jerusalem-science-museum/train_outside/אביזרים/truck_crane_nadneda/pic/20260311_140529.jpg

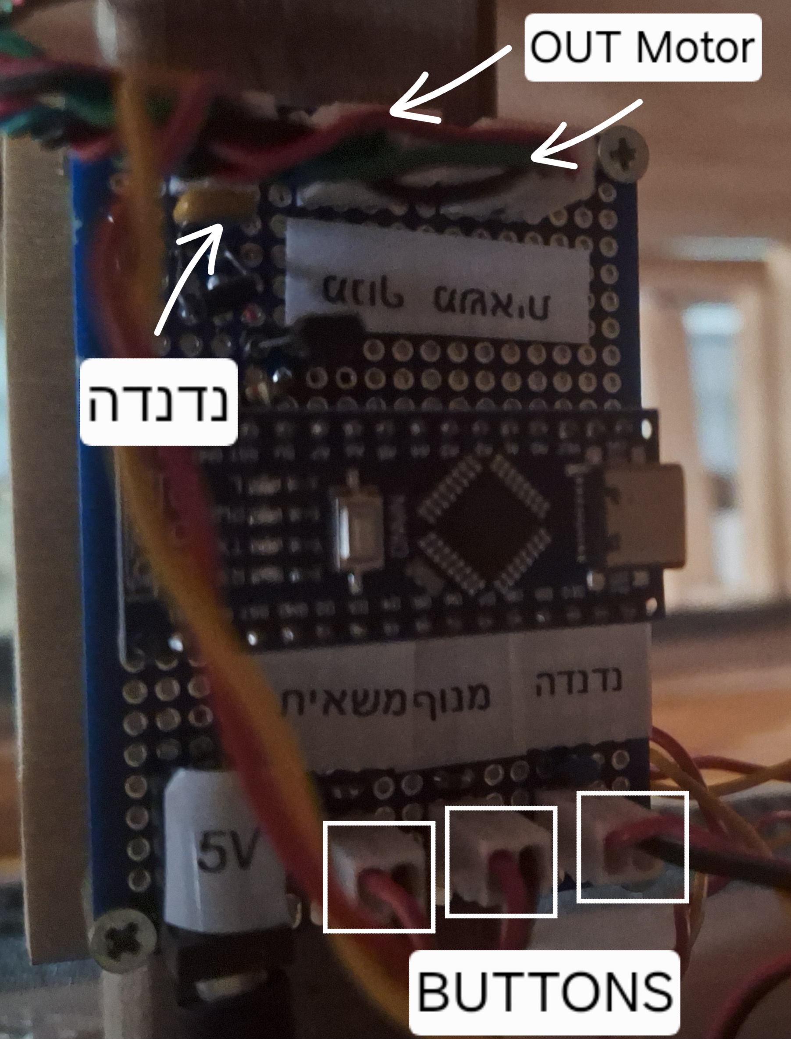
אביזרים/truck_crane_nadneda/pic/20260311_140529.jpg
