jerusalem-science-museum/train_outside/אביזרים/home_smoke/pic/20260309_175854.jpg

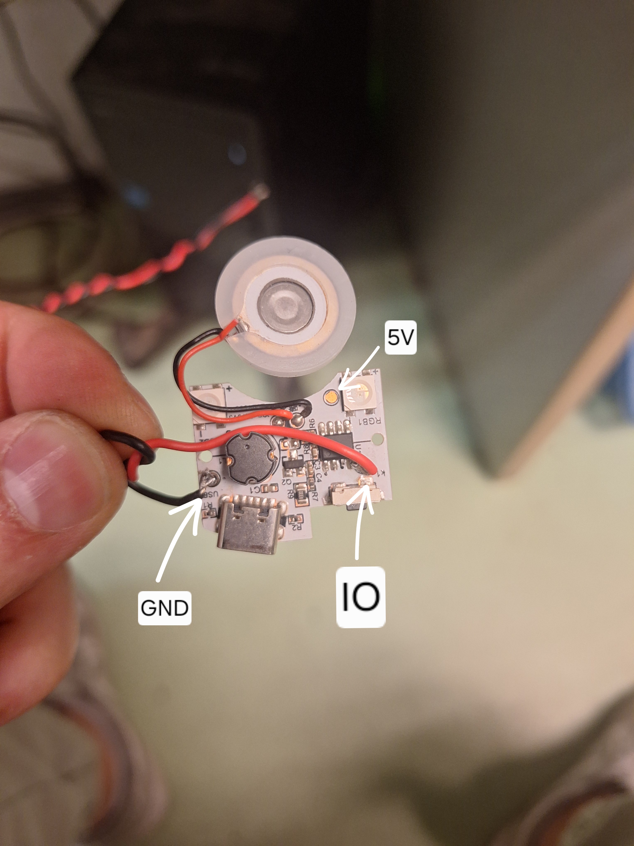
אביזרים/home_smoke/pic/20260309_175854.jpg
