jerusalem-science-museum/train_outside/פס רכבת/Easyeda_pcb/version2/Gerber_PCB_Train_Barrierx7_Opto/How-to-order-PCB.txt

How to Order PCB

Please refer to:
https://docs.easyeda.com/en/PCB/Order-PCB
