jerusalem-science-museum/train_outside/פס רכבת/אמיר/Train track controller.docx

## Story

Train track with n segments, and m trains (m < n). Track is a closed loop.

Controllers ensures that there are no more than one train in any segment

## Terminology

- Segment: a part of track
- Barrier: on entrance to a segment there is a barrier, if barrier is closed, trains cannot go into segment
- Sensor: after every barrier there is a sensor for detecting trains

Segment 1

Segment 2

Segment 3

barrier 1

barrier 2

barrier 3

sensor 1

sensor 2

sensor 3

## Algorithm

### Initial state:

- All barriers are closed

### Control:

- For every sensor i:

If sensor detects a train:

Close the barrier with index i (detected a train in segment i, therefore dont allow entrance)

Open the barrier with index i - 1 (the train came from i-1, so its free)

### Start flow

When we want to start the flow (when we turn on the system all barriers are closed), we need to “activate” manually the sensor that is “before” one of the trains

- Do we have access?
- Do we want to have a different method?

## Sensors

1. E3JK-R2M2:
  a. Relay output
  b. Retroreflector
  c. 12V+

##### 2. E18-D80NK

  a. 5V

# 3. E3F-DS30

  a. 6V
  b. npn/pnp/no/nc

## Output signal to barrier

Assumption: output is a “dry contact” (barrier has 2 wires, common and signal, and we short/ open the connection between them using a relay)
