jerusalem-science-museum/train_outside/נוהל סגירת קרון נכון לדצמבר 25.docx

נוהל סגירת קרון

סגירת קרון היא חלק אינטגרלי וחשוב בהפעלת המודל. סגירה נכונה ו"נקיה" תקל מאוד על התחלת ההפעלה הבאה.

מכיוון שהתהליך לוקח מספר דקות ורכבות רצות תוך ההליך ניתן לעשות זאת בנוכחות קהל אחרי הודעה לקהל שמתחילים לסגור.

מטרת הנוהל היא לא רק להשבית תנועת רכבות על המודל אלא להכין את המודל להפעלה הבאה. בסוף הנוהל כל הרכבות אמורות להיות בנקודת ההתחלה שלהם כשהן יושבות היטב על הפסים יחד עם קרונותיהם בהנחה שהללו מחוברים.

לעניין הקרונות: בשלב זה מדריכים מתבקשים שלא לחבר קרונות לרכבות עד שנלמד יותר טוב את הטכניקה ואז תועבר (בתקווה) הטכניקה למדריכים. מובן שקרונות שהתנתקו מרכבות צרכים להיות מוסרים מהפסים לא רק בנוהל הסגירה אלא כל אימת שניתוק כזה התרחש על מנת למנוע התנגשויות וקצרים. כרגיל זה נכון כמובן גם לרכבות אמתיות רק ,ששוב כרגיל ,הנזקים יכולים להיות הרבה יותר גדולים ולסכן חיי אדם והיו דברים מעולם..

נקודות הסיום (וההתחלה):

במקרה ומפעילים 4 רכבות נקודות הסיום הם ליד רמזורים ;1,7,6,5

במקרה ומפעילים 5 רכבות נקודות הסיום הם ליד רמזורים 1,7,6,5,4

הרכבת שמול רמזור 1 אינה עומדת ליד הרמזור עצמו אלא מול הסנטרל (ה"מחשב")

נוהל הסגירה:

במידה וקטרים רצים ללא קרונות מכבים ומדליקים את הארדואינו (סגירת כל הרמזורים) מורידים מהירויות לאפס דרך הסנטרל (ה"מחשב") ,מרימים את הקטרים ומניחים במקומות הנכונים תוך כדי שמוודאים שהם יושבים על הפסים כמו שצריך.

במידה ומחוברים קרונות לקטרים: אין להוריד בשום פנים רכבות עם קרונות מהפסים. זה ינתק את הקרונות. נכון לכרגע ומסיבות טכניות שונות חיבור הקרונות לקטרים דורש זמן ותשומת לב מרובה ומדריכים אינם מורשים לעשות זאת לעת עתה. הבאת הרכבות למקומות הנכונים תעשה במקרה זה בנסיעה בלבד.

הדרך הפשוטה ביותר היא כשהקטר הראשון בסבב מגיע מול הסנטרל יש להוריד את מהירותו ל-0 שאר הקטרים אמורים להגיע בעצמם לרמזורים ולהיעצר שם. שימו לב שכל הרכבות נמצאות מאחורי הרכבת הראשונה בסבב ולא צפויות התנגשויות. אחרת המשיכו להריץ עד להשגת התנאים הנכונים.

במקרה והרכבות לא הגיעו למקומות הנכונים יש להסיע אותן אחת אחת ע"י שליטה בארדואינו ובמהירויות. הסתכלות על הפסים וחשיבה יסיעו לעשות זאת יחסית בקלות.

לאחר שהרכבות הגיעו לתחנות הנכונות יש להוריד המהירות לאפס לכולם כך שמי שמתחיל שוב יוכל לבחור מהירויות בהתאם לצרכים.

ברגע שכל הרכבות במקומותיהם ומהירותם אפס אפשר לסגור את מתג החשמל הראשי של הקרון (מתג אדום על הקיר ב"חדרון") לצאת ולנעול את הקרון (מפתח מסטר ולא לשכוח).
