jerusalem-science-museum/train_outside/פס רכבת/סיכום_משא.docx

מיקום תחנות ו-Feedback.

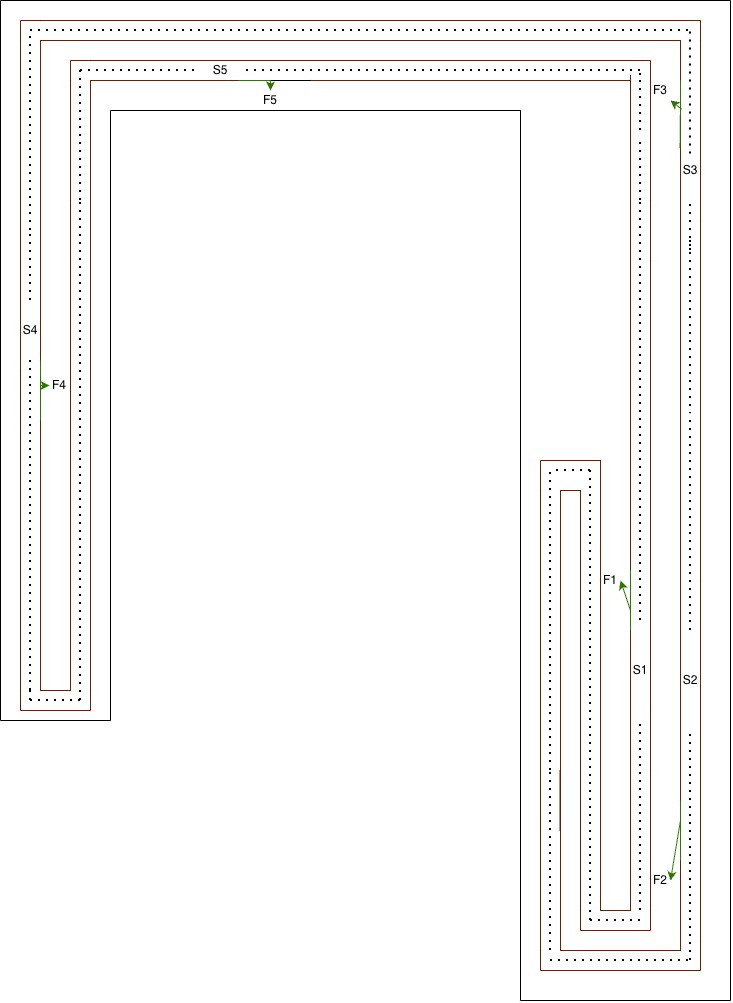
[picture p3: figure]

קופסת אלקטרוניקה

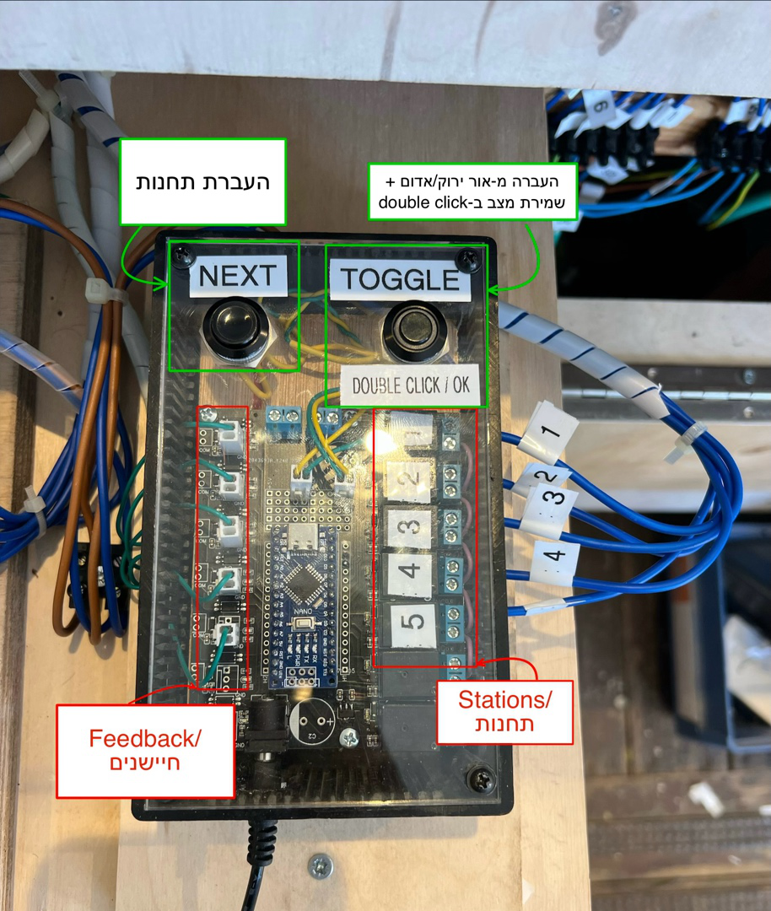
[picture p4: figure]
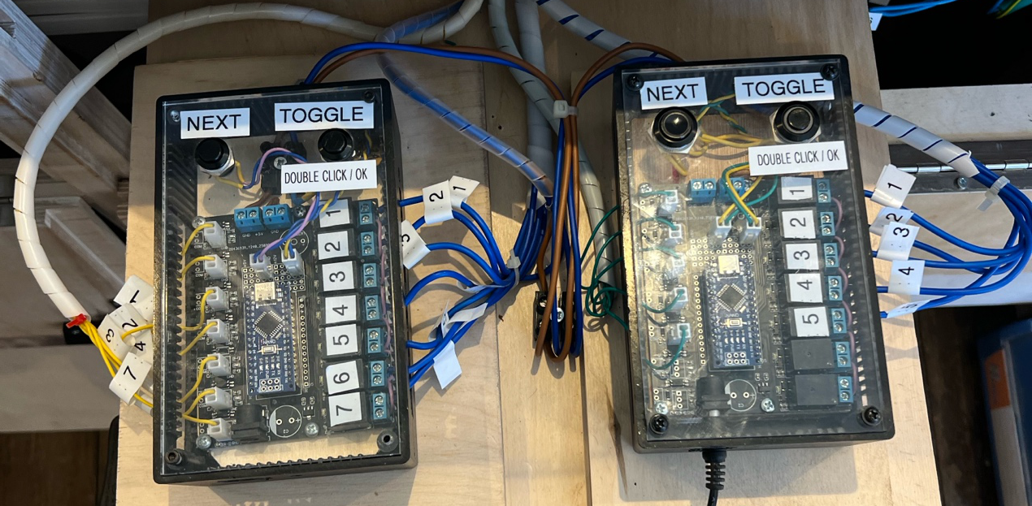
[picture p5: figure]

המערכות אחד ליד השני:

מערכת משא

מערכת נוסעים

חיווטים של התחנות:

משא

נוסעים

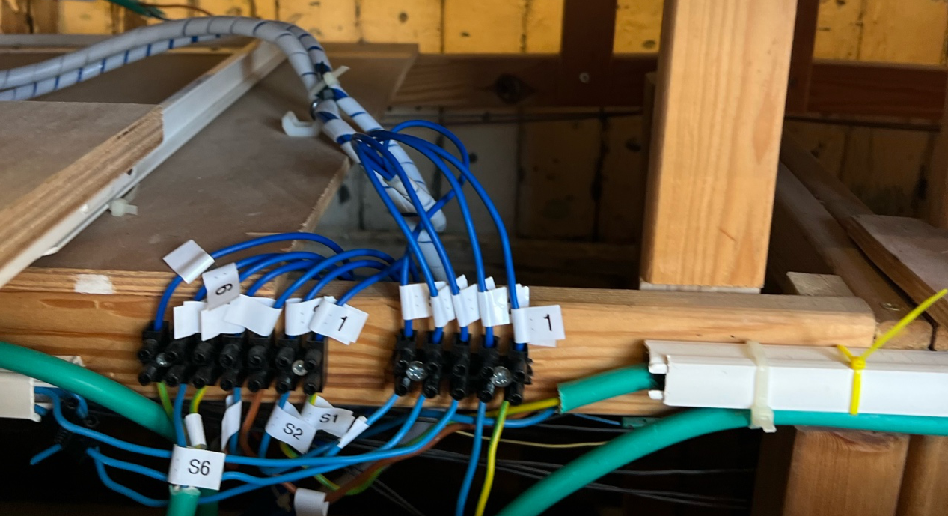
[picture p6: figure]

להפעלת המערכת ישנו מספר שלבים:

1. הדלקת ספק 12V.ברגע שמדליקים את הספק כל הלדים של התחנות נדלקות (כאשר לד של תחנה נדלק אין מתח בפסים הרמזור אדום).
2. בחירת תחנות. יש שתי כפתורים לבחירת תחנות ושנות את מצבם.
  - NEXT: מאפשר לעבור לתחנה הבאה (מ-1 ל-2...) וגם הופך את הרמזור לירוק
  - TOGGLE: מאפשר לעבור מאור ירוק לאור לאדום (שינוי מצב התחנה).
3. אישור סופי של בחירת תחנות. כאשר סיימנו לבחור את התחנות אם לוחצים Double Click על ה-TOGGLE אנו מאשרים את המסלול ולא ניתן לשנותו אלא על ידי ניתוק וחיבור הספק 12V.
4. למקם את הקרונות לתחנות הרלוונטיות.
5. לחיצה על כפתור STOP של ה-CENTRAL כדי לאפשר לתת מתח בפסים

מספר חיישן עם מספור מהמערכת הישנה

F1 → 12

F2 → 15

F3 → 18

F4 → 21

F5 → 22
