jerusalem-science-museum/train_outside/אביזרים/אזורים/אזור 1,2.jpg

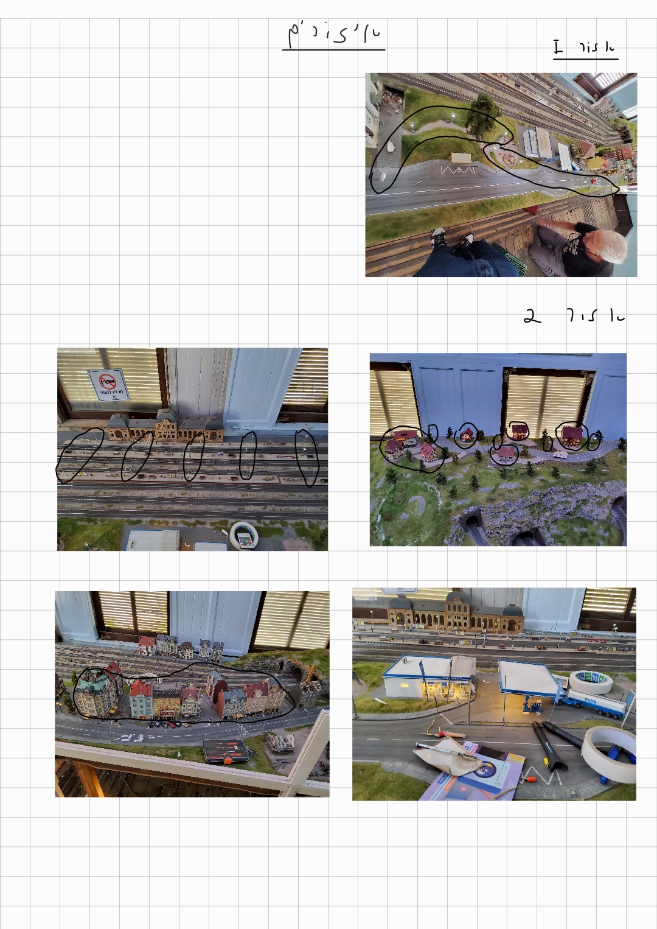
אביזרים/אזורים/אזור 1,2.jpg
