jerusalem-science-museum/train_outside/אביזרים/אזורים/אזור 3.jpg

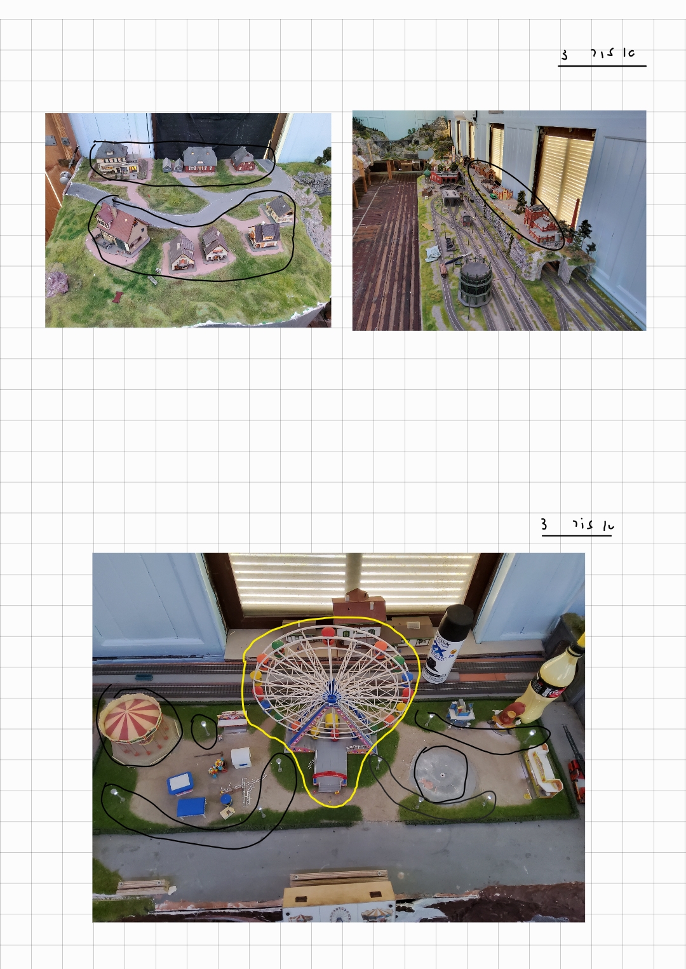
אביזרים/אזורים/אזור 3.jpg
