jerusalem-science-museum/train_outside/אביזרים/אזורים/אזור 4,5,6.jpg

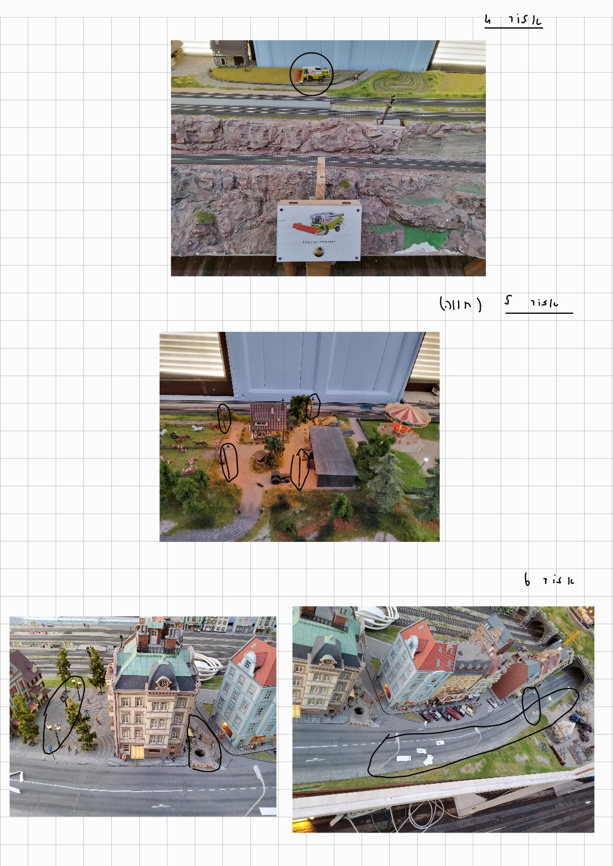
אביזרים/אזורים/אזור 4,5,6.jpg
