jerusalem-science-museum/train_outside/אביזרים/אזורים/אזור 7,8.jpg

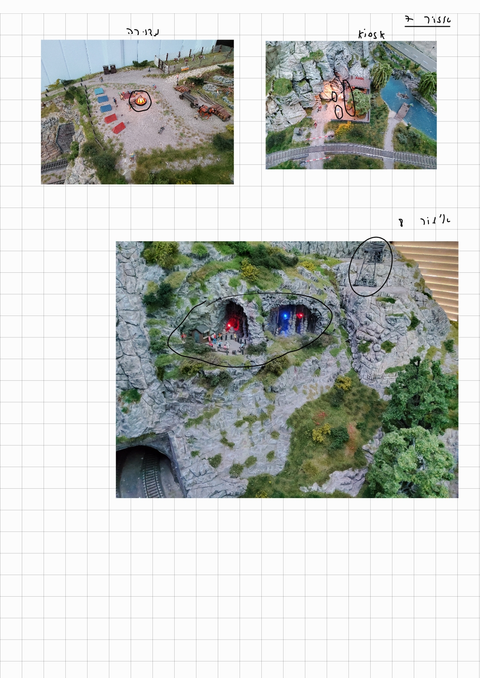
אביזרים/אזורים/אזור 7,8.jpg
