jerusalem-science-museum/train_outside/אביזרים/ספקים/ספק 1,2,3.jpg

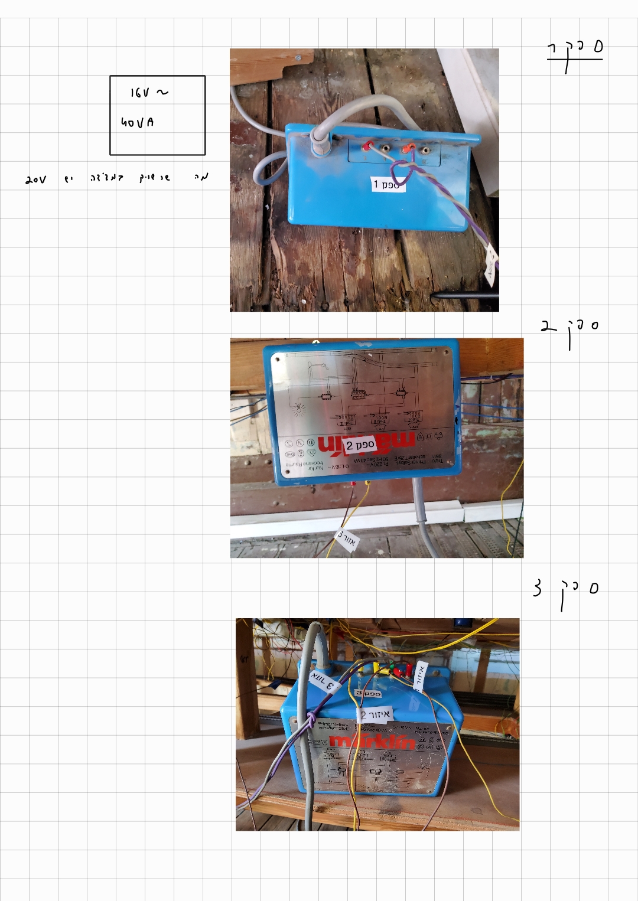
אביזרים/ספקים/ספק 1,2,3.jpg
