jerusalem-science-museum/train_outside/אביזרים/ספקים/ספק 4,5,6.jpg

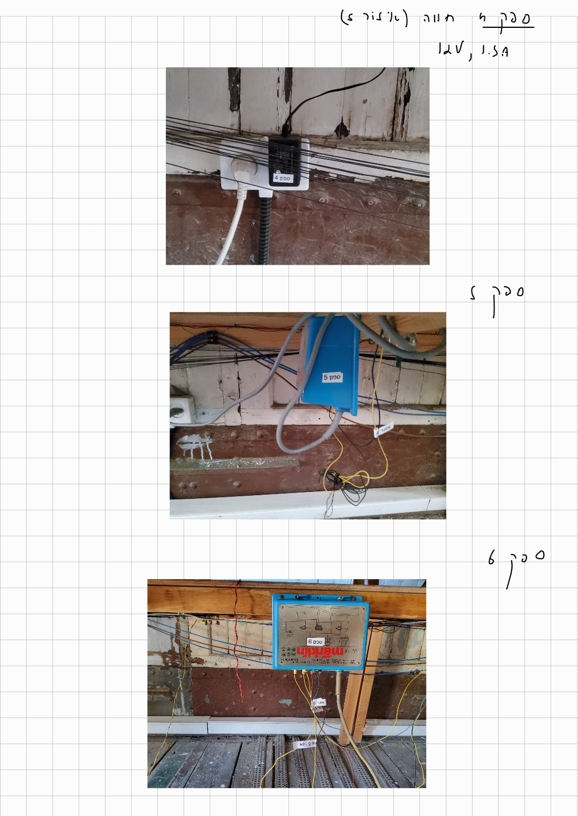
אביזרים/ספקים/ספק 4,5,6.jpg
