jerusalem-science-museum/train_outside/אביזרים/ספקים/ספק 7,8,9.jpg

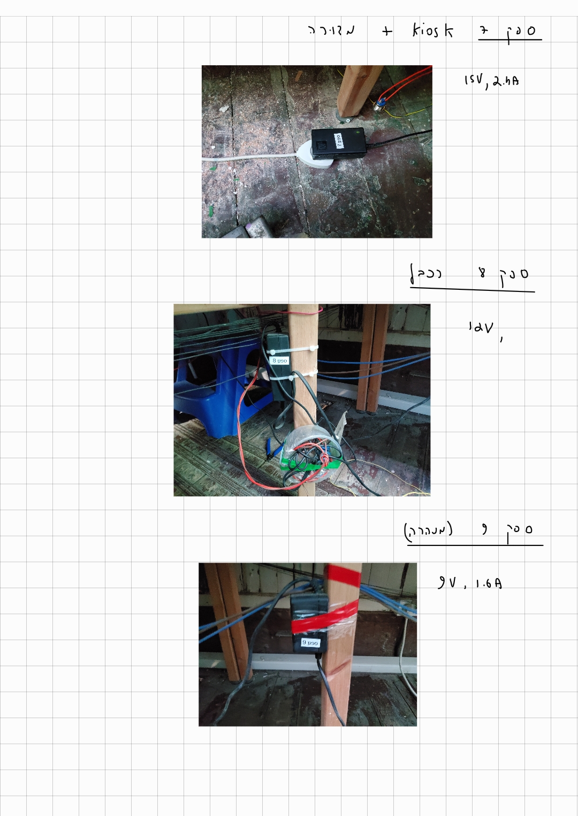
אביזרים/ספקים/ספק 7,8,9.jpg
