jerusalem-science-museum/train_outside/אביזרים/תקלות/תרשים מלבני_250330_154424_11 (1).jpg

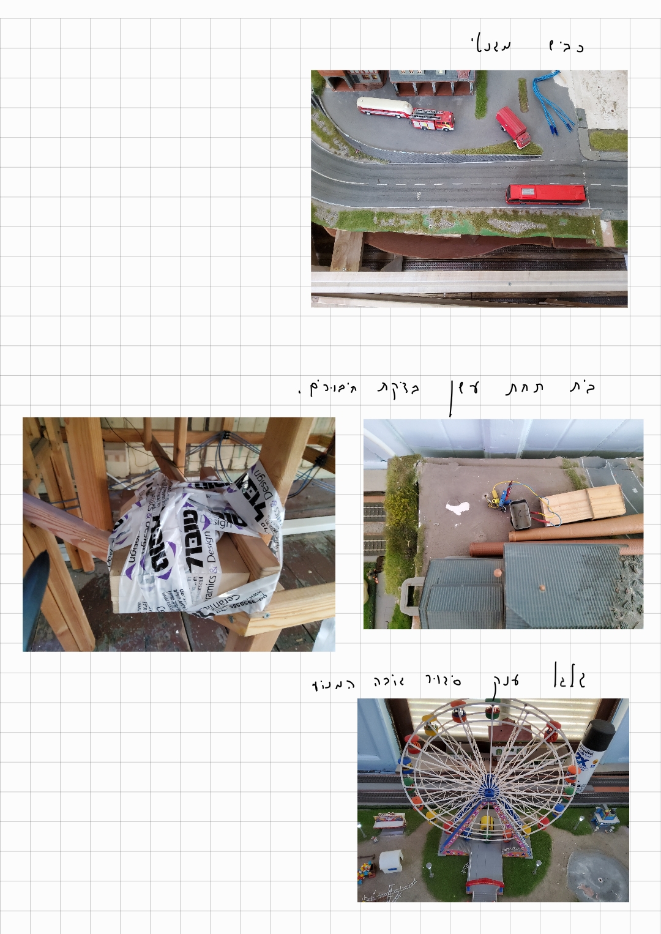
אביזרים/תקלות/תרשים מלבני_250330_154424_11 (1).jpg
