jerusalem-science-museum/train_outside/פס רכבת/אמיר/תמונות/IMG_20220703_014758.jpg

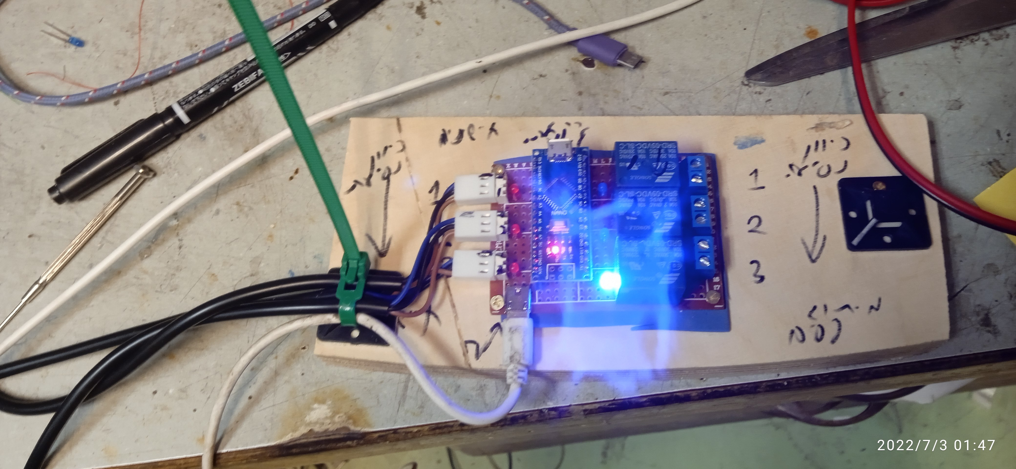
פס רכבת/אמיר/תמונות/IMG_20220703_014758.jpg
