jerusalem-science-museum/train_outside/פס רכבת/אמיר/תמונות/IMG_20220703_031803_1.jpg

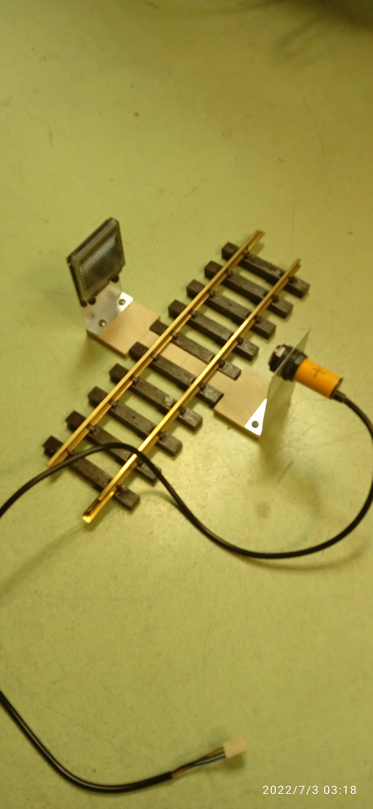
פס רכבת/אמיר/תמונות/IMG_20220703_031803_1.jpg
