jerusalem-science-museum/train_outside/פס רכבת/תמונות/feedbak_to ard.jpg

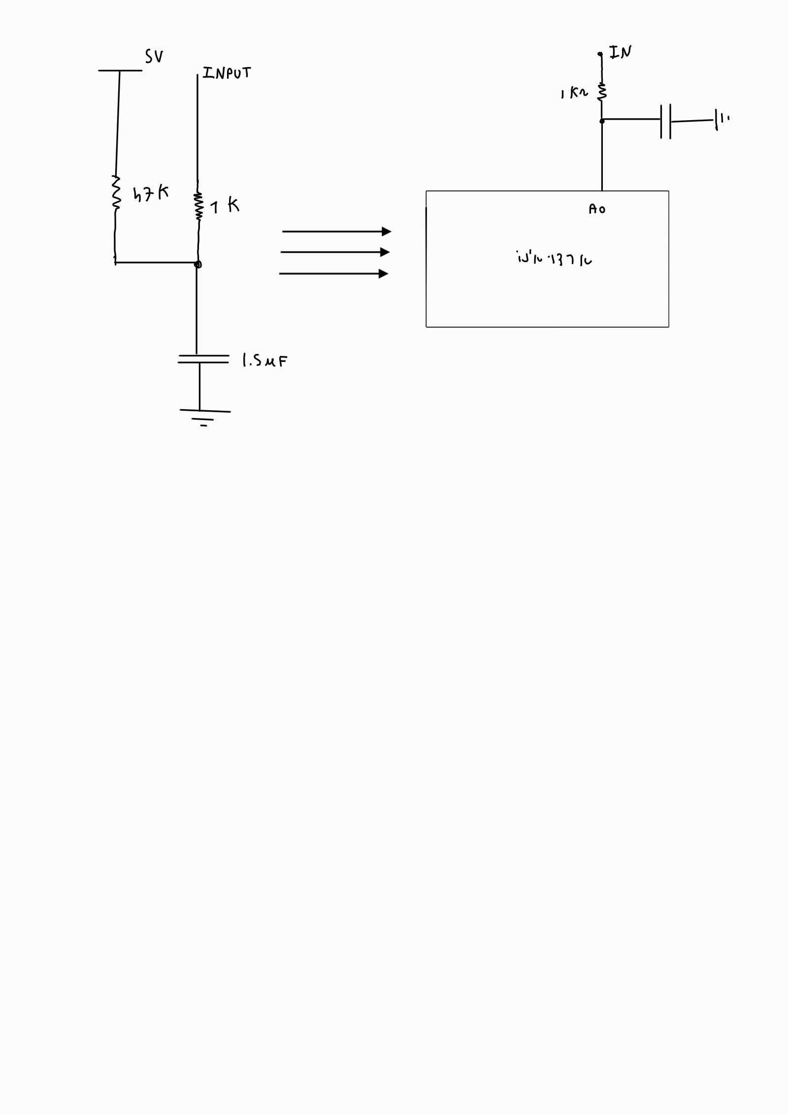
פס רכבת/תמונות/feedbak_to ard.jpg
