jerusalem-science-museum/train_outside/פס רכבת/תמונות/חיבור_בוסטר.jpg

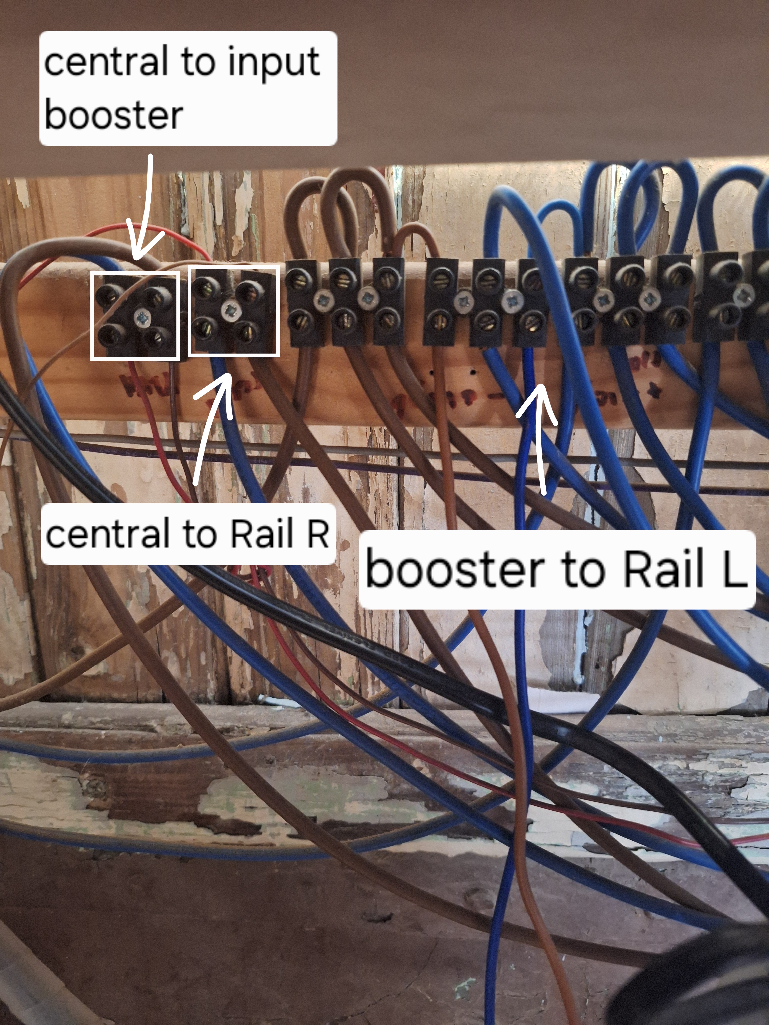
פס רכבת/תמונות/חיבור_בוסטר.jpg
