jerusalem-science-museum/train_outside/פס רכבת/תמונות/חיבור_בוסטר_2.jpg

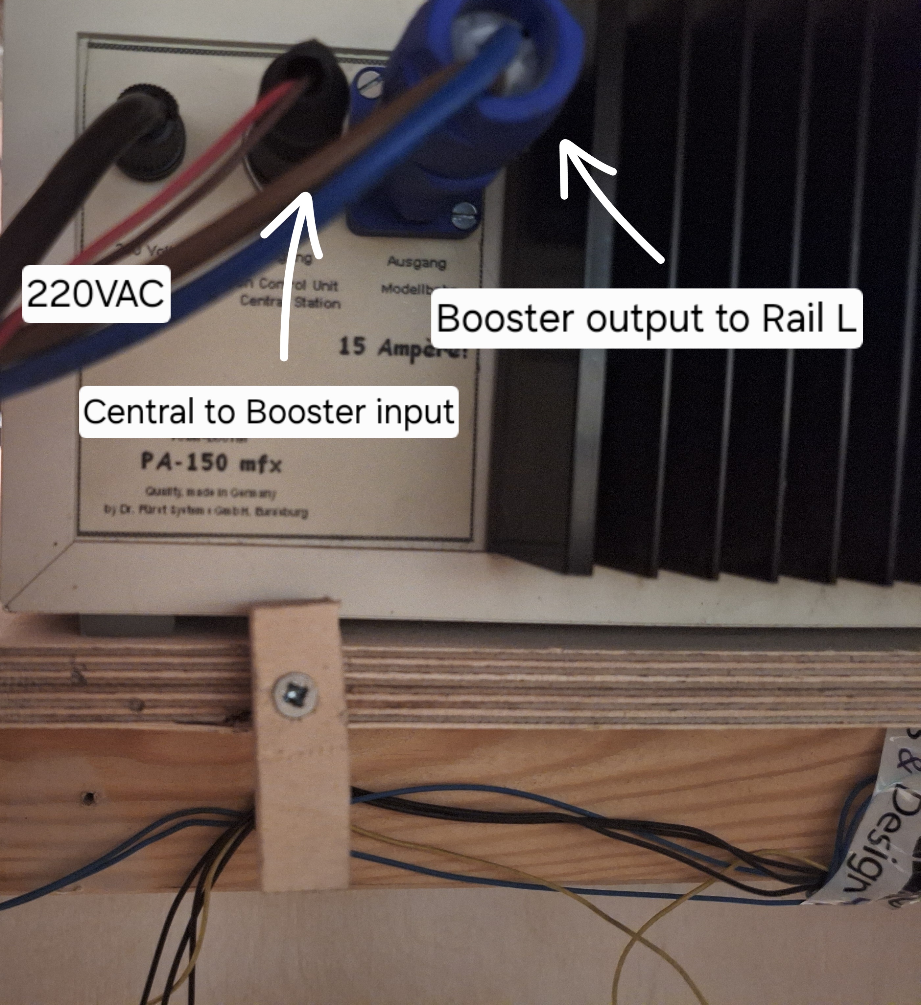
פס רכבת/תמונות/חיבור_בוסטר_2.jpg
