jerusalem-science-museum/train_outside/פס רכבת/תמונות/רשימת חיבורים.jpg

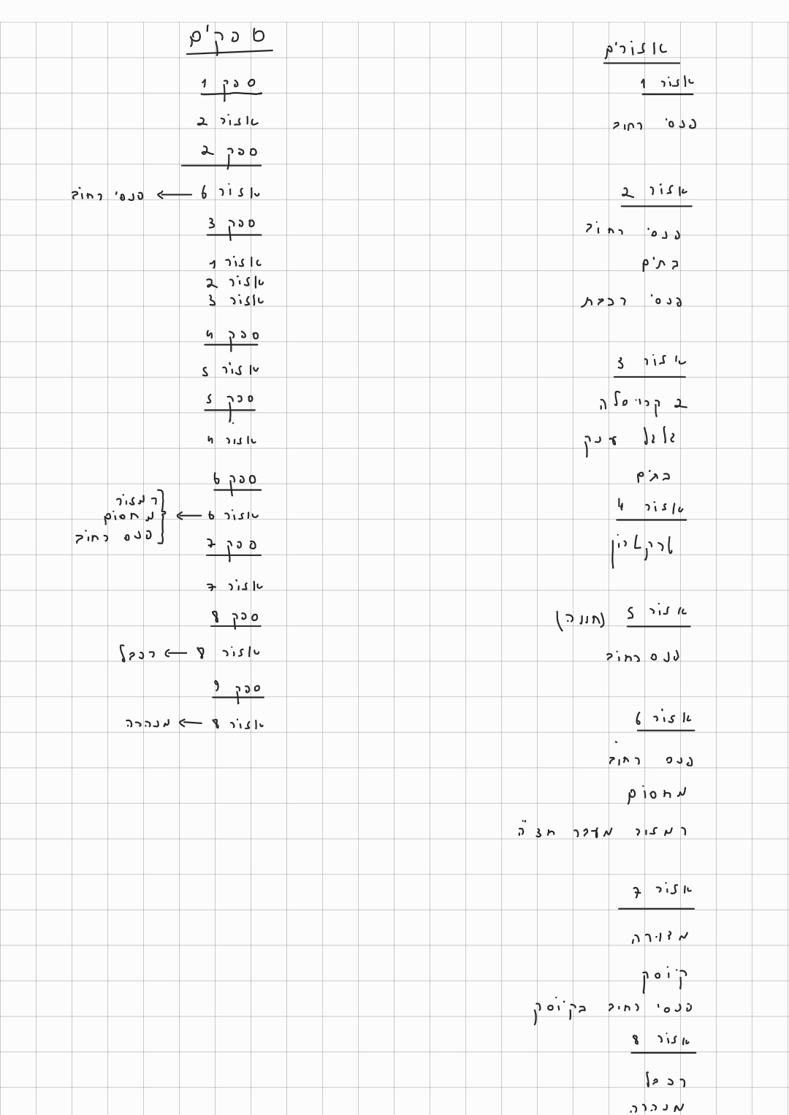
פס רכבת/תמונות/רשימת חיבורים.jpg
