jerusalem-science-museum/train_outside/פס רכבת/תמונות/תרשים _250831_224947 (1).jpg

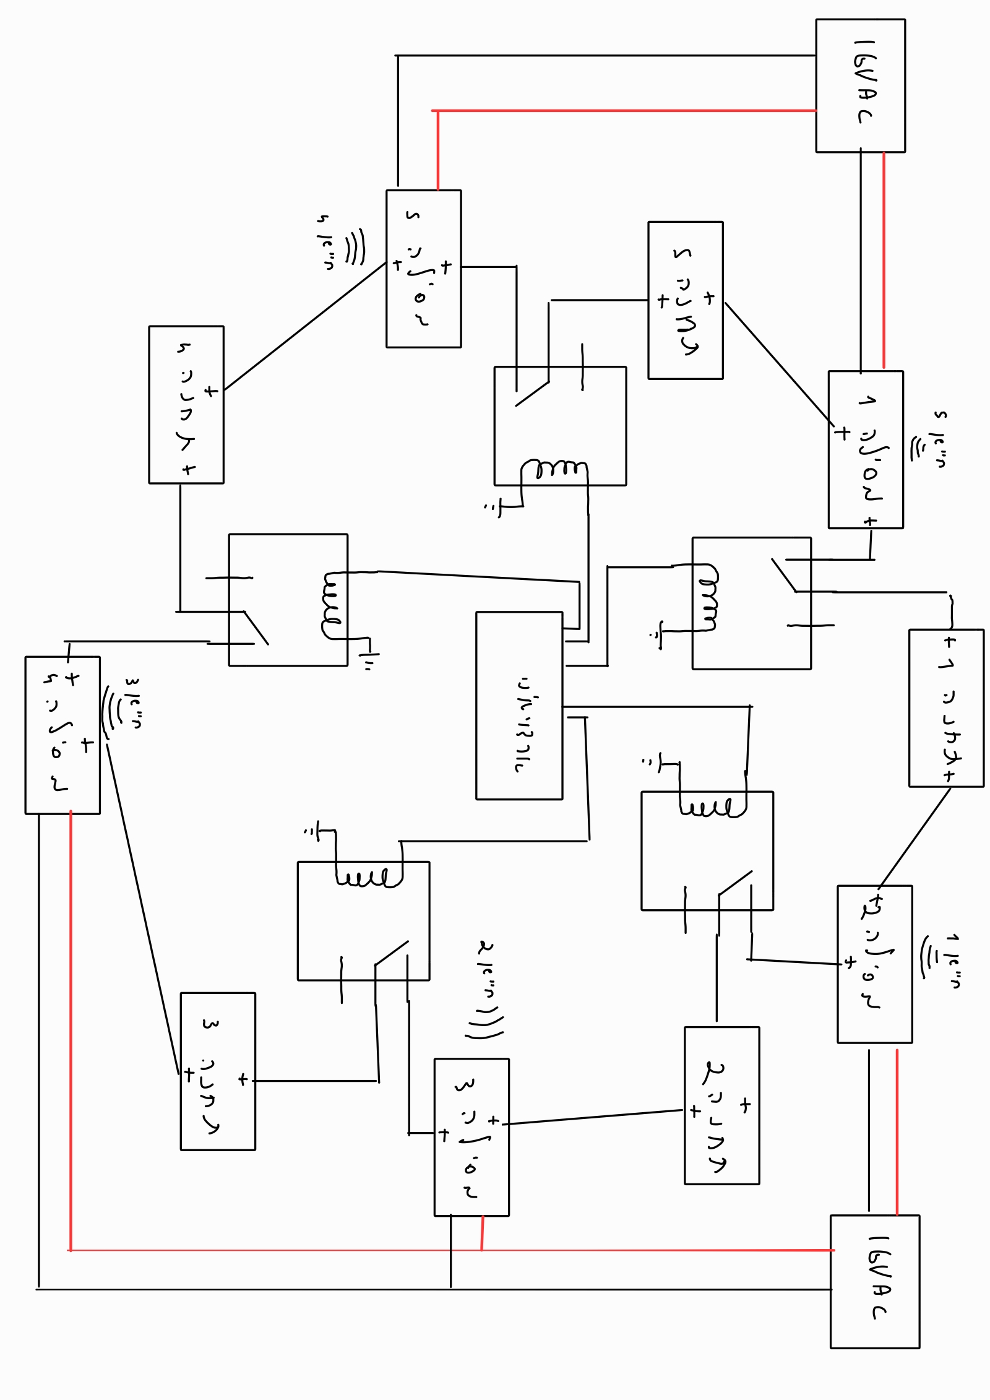
פס רכבת/תמונות/תרשים _250831_224947 (1).jpg
