jerusalem-science-museum/train_outside/פס רכבת/תמונות/תרשים מלבני רכבת_251026_133534.jpg

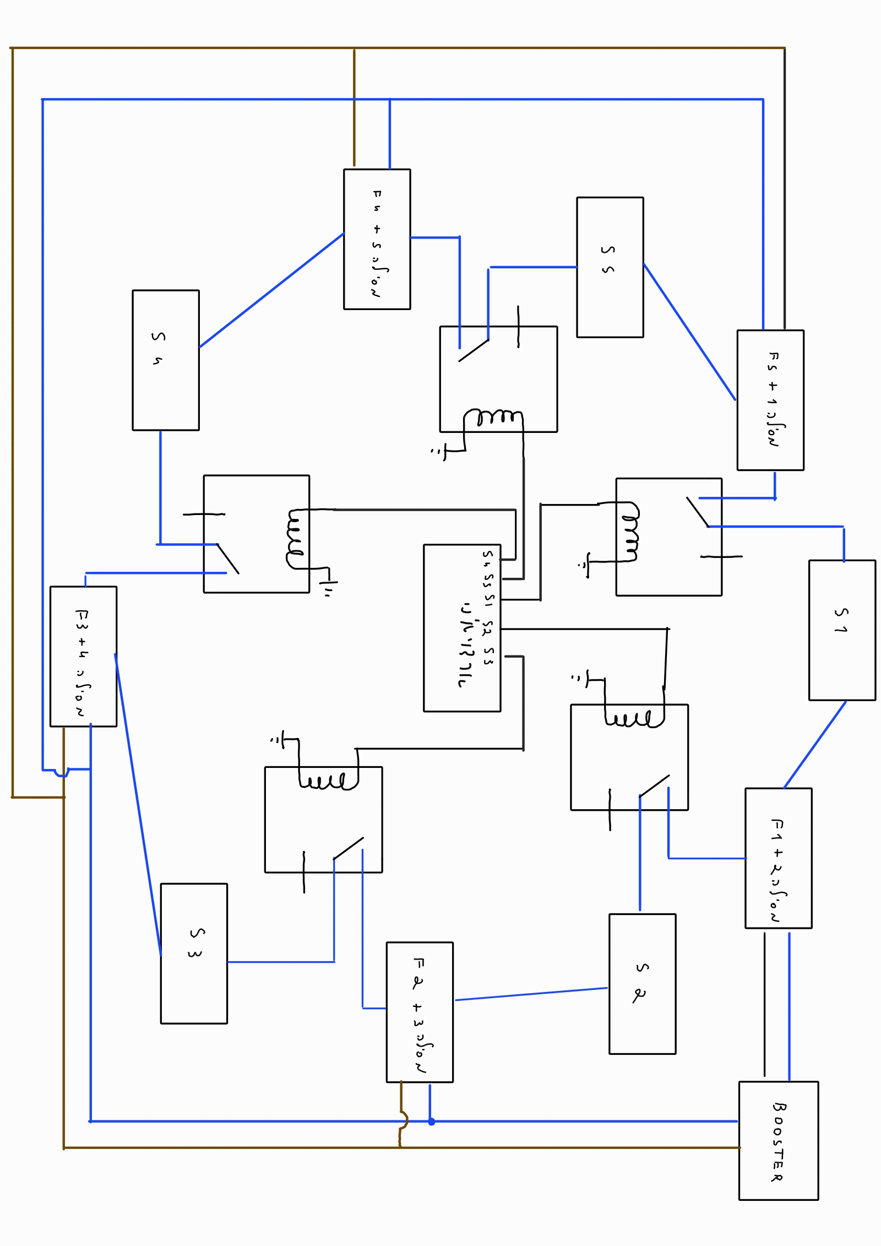
פס רכבת/תמונות/תרשים מלבני רכבת_251026_133534.jpg
