jerusalem-science-museum/train_outside/פס רכבת/תמונות/תרשים מלבני.jpg

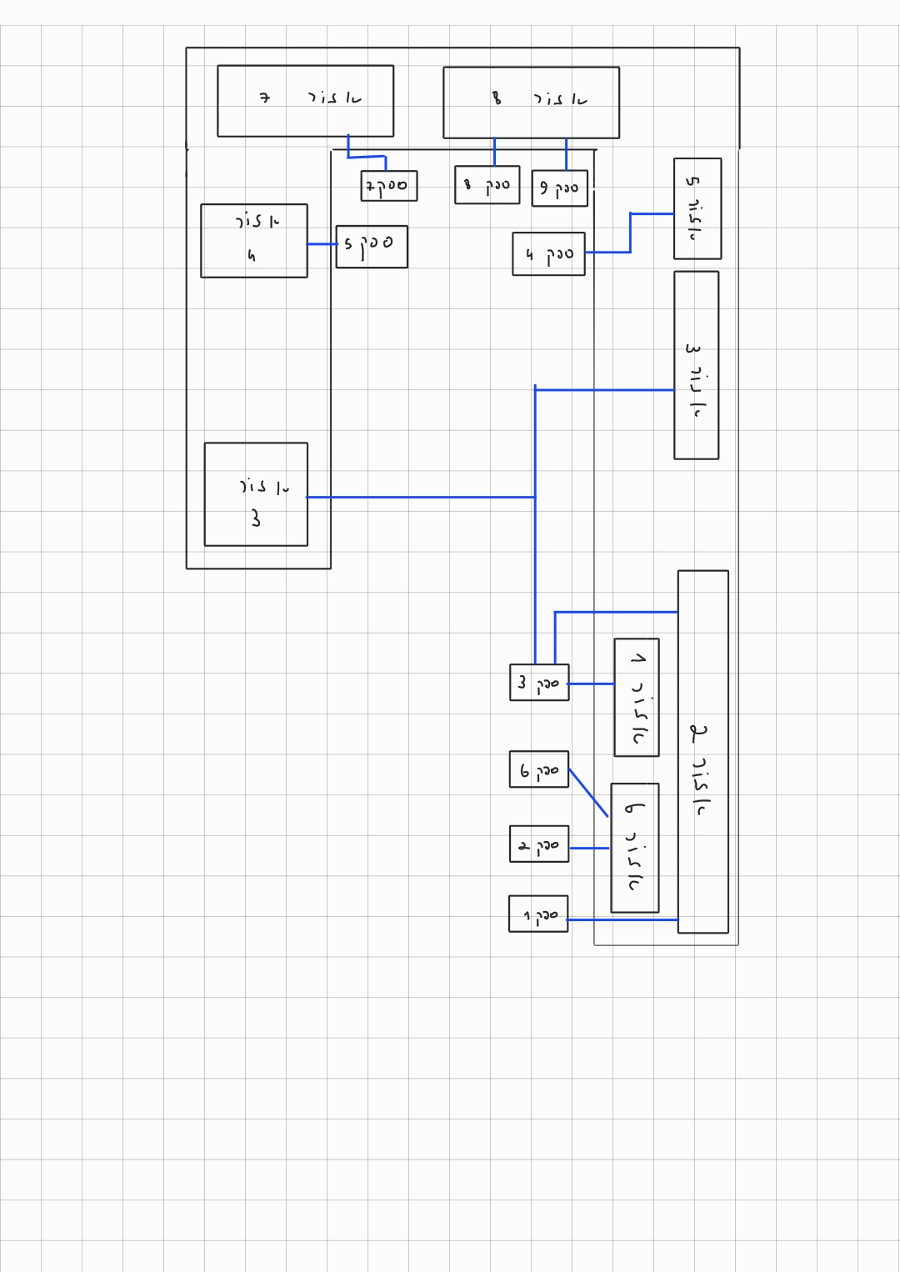
פס רכבת/תמונות/תרשים מלבני.jpg
