jerusalem-science-museum/train_outside/פס רכבת/Easyeda_pcb/version2/BOM_PCB_Train_Barrierx7_Opto_2025-08-31.csv

ID | Name | Designator | Footprint | Quantity | Manufacturer Part | Manufacturer | Supplier | Supplier Part | Price | Pins | 3DModel | Contributor | Package Display | Resistance (Ohms) | link
1 | 100nF | CIN1,CIN2,CIN3,CIN4,CIN5,CIN6,CIN7,COC2,COC3,COC4,COC5,COC6,COC7,COC1,C3,C5 | C0603 | 16 | CC0603KRX7R9BB104 | YAGEO | LCSC | C14663 | 0.002 | 2 | C0603_L1.6-W0.8-H0.8 | lcsc | No |  | https://item.szlcsc.com/362304.html
2 | 1kΩ | RS1,RS2,RS3,RS4,RS5,RS6,RS7,GR4,AR4,BR4,CR4,DR4,ER4,FR4 | R0603 | 14 | 0603WAF1001T5E | UniOhm | LCSC | C21190 | 0.001 | 2 | R0603_L1.6-W0.8-H0.8 | lcsc | No | 1K | https://www.mouser.in/datasheet/2/447/PYu_RT_1_to_0_01_RoHS_L_11-1669912.pdf
3 | BUZZER-12X9 | BUZZER1 | BUZ-TH_BD12.0-P7.60-D0.6-FD | 1 | buzzer-12X9 | null | LCSC | C9900016920 |  | 2 | BUZ-TH_D12.0-H9.5-P7.60 | lcsc | No |  | https://item.szlcsc.com/200842.html
4 | CR5V | CR5V | CONN-TH_P5.00_KF301-5.0-2P | 1 | KF301-5.0-2P | Cixi Kefa Elec | LCSC | C474881 | 0.086 | 2 | CONN-TH_P5.00_KF301-5.0-2P | LCSC | No |  | https://item.szlcsc.com/481499.html
5 | CR12V | CR12V | CONN-TH_P5.00_KF301-5.0-2P | 1 | KF301-5.0-2P | Cixi Kefa Elec | LCSC | C474881 | 0.086 | 2 | CONN-TH_P5.00_KF301-5.0-2P | LCSC | No |  | https://item.szlcsc.com/481499.html
6 | KF2510-2A | ACON2,ACON3,ACON4,ACON5,ACON6,ACON7,ACON1 | CONN-TH_KF2510-2A | 7 | KF2510-2A | BOOMELE | LCSC | C27543 | 0.015 | 2 | CONN-TH_KF2510-2A | lcsc | No |  | https://item.szlcsc.com/28292.html
7 | FK2510 | ACN,BCN,CCN,DCN,ECN,FCN,GCN | CONN-TH_3P-P2.00_KF2510_3A | 7 | 2510-3A | BOOMELE(博穆精密) | LCSC | C29275 | 0.016 | 3 | CONN-TH_KF2.54-LI-3P | 立创EDA官方封装库 | No |  | https://item.szlcsc.com/30027.html
8 | SM4007PL | DOC2,DOC3,DOC4,DOC5,DOC6,DOC7,DOC1,GD,AD,BD,CD,DD,ED,FD | SOD-123F_L2.8-W1.8-LS3.7-RD | 14 | SM4007PL | MDD(辰达半导体) | LCSC | C64898 | 0.005 | 2 | SOD-123FL_L2.8-W1.8-LS3.7-RD-1 | lcsc | No |  | https://item.szlcsc.com/60254.html
9 | 1K | ROC2,ROC3,ROC4,ROC5,ROC6,ROC7,ROC1,GR1,GR2,AR1,AR2,BR1,BR2,CR1,CR2,DR1,DR2,ER1,ER2,FR1,FR2 | R0603 | 21 | 0603WAF1001T5E | UniOhm | LCSC | C21190 | 0.001 | 2 | R0603_L1.6-W0.8-H0.8 | lcsc | No | 1K | https://www.mouser.in/datasheet/2/447/PYu_RT_1_to_0_01_RoHS_L_11-1669912.pdf
10 | LTV-217-B-G | U2,U3,U4,U5,U6,U7,U1 | SOP-4_L4.4-W2.8-P1.27-LS7.0-BR | 7 | LTV-217-B-G | LITEON(光宝) | LCSC | C115450 | 0.062 | 4 | SOP-4_L4.4-W2.8-P1.27-LS7.0-BR | LCSC | No |  | https://item.szlcsc.com/222785.html
11 | 0Ω | GR3,AR3,BR3,CR3,DR3,ER3,FR3 | R0402 | 7 | 0402WGF0000TCE | UniOhm | LCSC | C17168 | 0.001 | 2 | R0402_L1.0-W0.5-H0.5 | lcsc | No | 0 | https://item.szlcsc.com/323315.html
12 | AO3400A | GQ,AQ,BQ,CQ,DQ,EQ,FQ | SOT-23-3_L2.9-W1.3-P1.90-LS2.4-BR | 7 | AO3400A | AOS | LCSC | C20917 | 0.073 | 3 | SOT-23-3P_L2.9-W1.3-H1.0-LS2.4-P0.95 | lcsc | No |  | https://www.diodes.com/assets/Package-Files/SOT23.pdf
13 | 0603White light_C2290 | GL,AL,BL,CL,DL,EL,FL | LED0603-R-RD_WHITE | 7 | KT-0603W | KENTO | LCSC | C2290 | 0.011 | 2 | LED0603-R-RD_WHITE | lcsc | No |  | https://atta.szlcsc.com/upload/public/pdf/source/20180604/C192669_B0D472CB769BD043C4F2A33F1E72AA62.pdf
14 | SRA-12VDC-CL | GK,AK,BK,CK,DK,EK,FK | RELAY-TH_SRA-X-CX | 7 | SRA-12VDC-CL | 松乐 | LCSC | C60169 | 0.284 | 5 | RELAY-TH_L16.0-W12.4-H14.2-C | lcsc | No |  | https://item.szlcsc.com/61221.html
15 | CR | GCR,ACR,BCR,CCR,DCR,ECR,FCR | CONN-TH_P5.00_KF301-5.0-2P | 7 | KF301-5.0-2P | Cixi Kefa Elec | LCSC | C474881 | 0.086 | 2 | CONN-TH_P5.00_KF301-5.0-2P | LCSC | No |  | https://item.szlcsc.com/481499.html
16 | KT-0603R | GLR,ALR,BLR,CLR,DLR,ELR,FLR | LED0603-RD | 7 | KT-0603R | KENTO | LCSC | C2286 | 0.006 | 2 | LED0603-RD | lcsc | No |  | https://item.szlcsc.com/347874.html
17 | 1000uF | C2 | CAP-TH_BD12.5-P5.00-D0.6-FD | 1 | 1000uF 50V | ValuePro | LCSC | C18104 | 0.22 | 2 | CAP-TH_D12.5-H20.0-P5.00 | lcsc | No |  | https://atta.szlcsc.com/upload/public/pdf/source/20171212/C160628_15130639756271177994.pdf
18 | HDR-F-2.54_1x5 | H3,H4,H5,H6,H12,H9,H7,H10,H11,H8 | HDR-F-2.54_1X5 | 10 |  |  | LCSC | C50950 | 0.064 | 5 | HDR-F-2.54_1x5 | LCEDA_Lib | No
19 | 78L05_C842819 | 78L05 | SOT-89-3_L4.5-W2.5-P1.50-LS4.2-BR | 1 | 78L05 | FUXINSEMI | LCSC | C842819 | 0.043 | 3 | SOT-89-3_L4.3-W2.5-H1.6-LS4.1-P1.50 | LCSC | No |  | https://item.szlcsc.com/421845.html
20 | DC-063-20A | DC2 | DC-IN-TH_DC-063-20A | 1 | DC-063-20A | 韩国韩荣 | LCSC | C707268 | 0.181 | 3 | DC-IN-TH_DC-063-20A | LCSC | No |  | https://item.szlcsc.com/744390.html
21 | HDR-F-2.54_1x15 | H1,H2 | HDR-F-2.54_1X15 | 2 |  |  | LCSC | C124408 | 0.251 | 15 | HDR-F-2.54_1x15 | LCEDA_Lib | No
22 | Arduino_Nano_Header | J1 | DIP-30_L43.18-W15.24-ARDUINONANO | 1 |  |  |  |  |  | 30 |  | OSHWHub
