jerusalem-science-museum/train_outside/(list of files, drawings)

Other design files:
פס רכבת/Easyeda_pcb/version1/PCB_Train_Barrier.json
פס רכבת/Easyeda_pcb/version2/Train_Barrierx7_OPTO/PCB_Train_Barrierx7_Opto.json
